felipeliras/lira-plc/README.md

# lira-plc

## Disclaimer
This project includes CAD models provided by Phoenix Contact for integration into the PCB assembly. The CAD files are used in accordance with Phoenix Contact’s usage rights for the purpose of distributing and documenting this project. Phoenix Contact remains the owner and author of the original CAD files. All product names, logos, and trademarks are the property of their respective owners.
