felipeliras/lira-plc/hardware/lira-plc.step

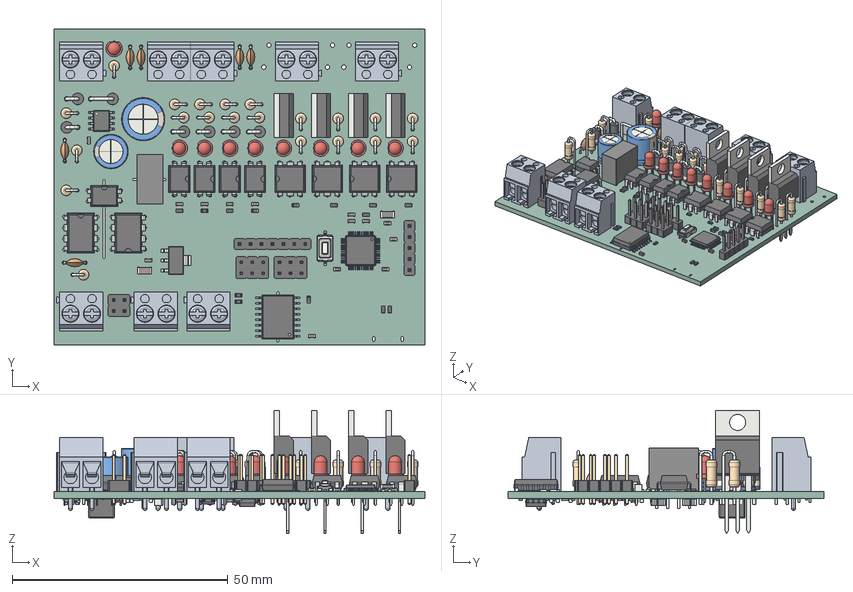
[picture p1: CAD file, 2025-01-07]
hardware/lira-plc.step
86.0 x 73.2 x 28.5 mm
D_DO-41_SOD81_P2.54mm_Vertical_AnodeUp x 6
R_Axial_DIN0207_L63mm_D25mm_P254mm_Vertical x 21
DIP-4_W7.62mm x 5
R_0603_1608Metric x 33
C_Disc_D43mm_W19mm_P500mm x 6
PinHeader_1x05_P254mm_Vertical
LED_D3.0mm x 9
CP_Radial_D80mm_P380mm
C_0603_1608Metric x 29
mps_dcdc_mee1s_sc_a
BR002 x 8
TO-220-3_Vertical x 4
PinHeader_2x03_P254mm_Vertical x 2
DIP-8_W7.62mm x 2
SOIC_16W_75x103mm_P127mm
L_1206_3216Metric x 3
DIP-6_W7.62mm x 4
CP_Radial_D100mm_P500mm
PinHeader_1x07_P254mm_Vertical
PTS636Sx25SMTRLFS
LQFP_48_7x7mm_P05mm
SOIC_8_39x49mm_P127mm x 2
SOT_223
PinHeader_2x02_P254mm_Vertical
C_1206_3216Metric
D_DO-41_SOD81_P5.08mm_Vertical_AnodeUp
SOT-23-3
L_APV_ANR6045
lira-plc_PCB
