felipeliras/lira-plc/hardware/lira-plc.kicad_pcb

## KiCad design hardware/lira-plc.kicad_pcb (2025-01-09)

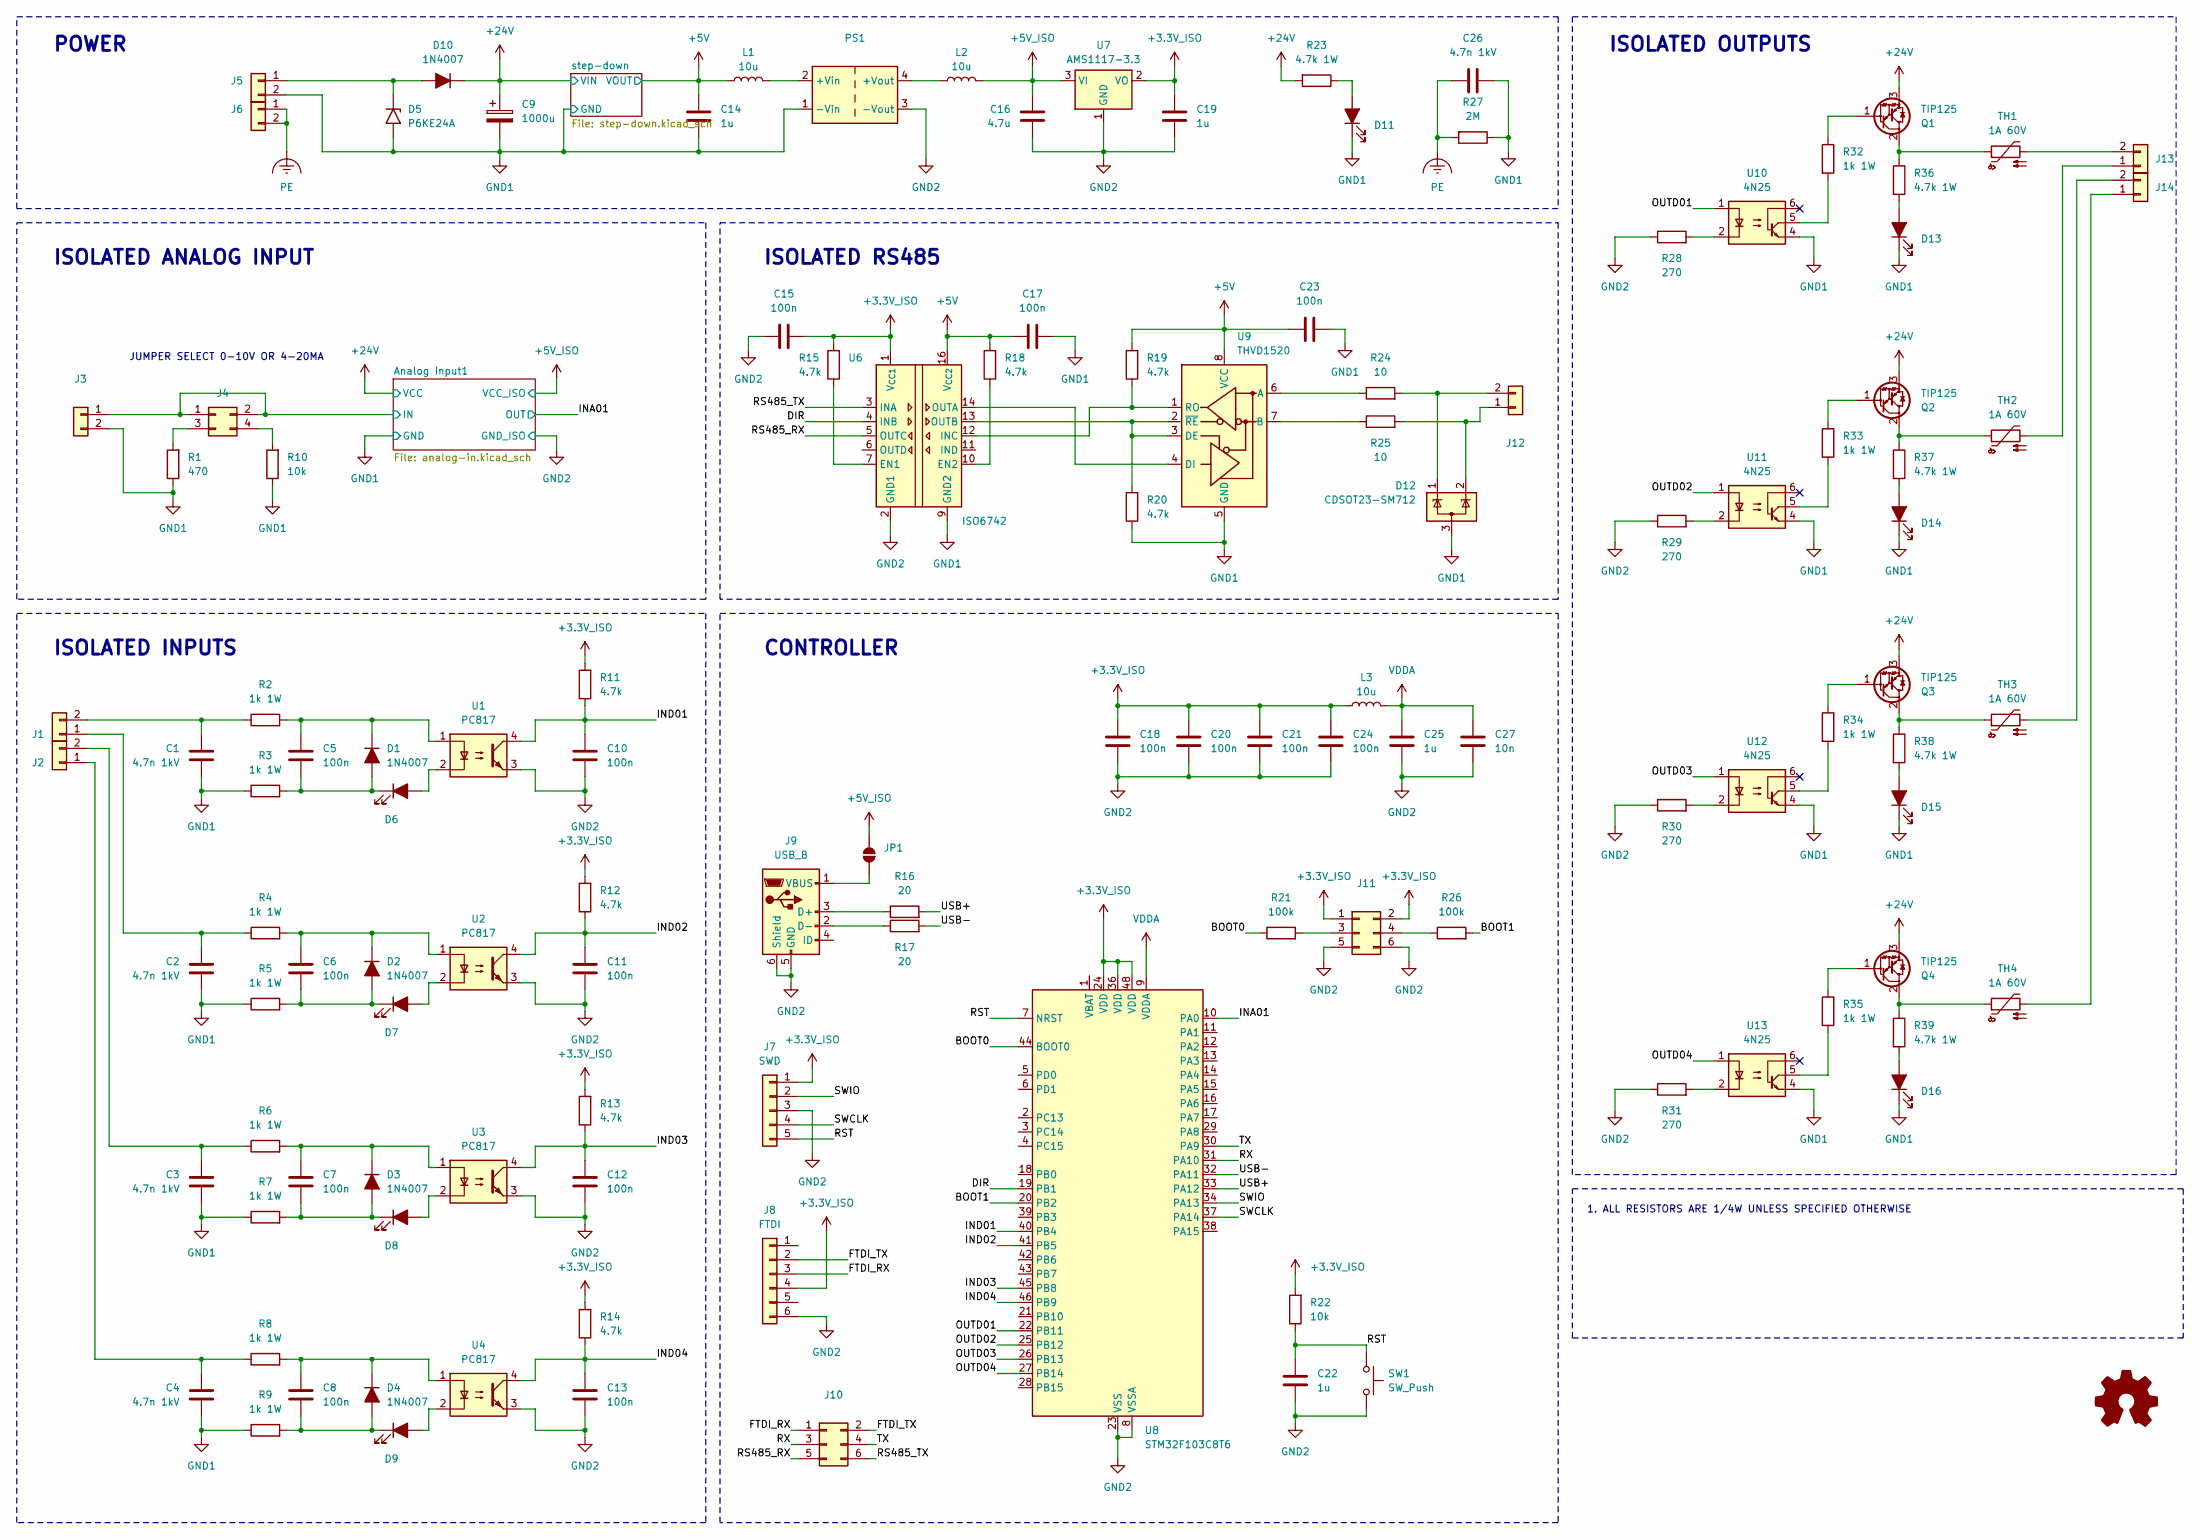
[picture p2: schematic lira-plc.kicad_sch]

Parts:
C1, C2, C3, C4, C26: 4.7n 1kV; C_Disc_D4.3mm_W1.9mm_P5.00mm
C5, C6, C7, C8, C10, C11, C12, C13, C15, C17, C18, C20, C21, C23, C24: 100n; C_0603_1608Metric_Pad1.08x0.95mm_HandSolder
C9: 1000u; CP_Radial_D10.0mm_P5.00mm
C14, C19, C22, C25: 1u; C_0603_1608Metric_Pad1.08x0.95mm_HandSolder
C16: 4.7u; C_1206_3216Metric_Pad1.33x1.80mm_HandSolder
C27: 10n; C_0603_1608Metric_Pad1.08x0.95mm_HandSolder
D1, D2, D3, D4: 1N4007; D_DO-41_SOD81_P2.54mm_Vertical_AnodeUp
D5: P6KE24A; D_DO-41_SOD81_P2.54mm_Vertical_AnodeUp
D6, D7, D8, D9, D11, D13, D14, D15, D16: LED_Filled; LED_D3.0mm
D10: 1N4007; D_DO-41_SOD81_P5.08mm_Vertical_AnodeUp
D12: CDSOT23-SM712; SOT-23-3
J1, J2, J3, J5, J6, J12, J13, J14: Conn_01x02; Metaltex-BR0
J4: Conn_02x02_Counter_Clockwise; PinHeader_2x02_P2.54mm_Vertical
J7: SWD; PinHeader_1x05_P2.54mm_Vertical
J8: FTDI; PinHeader_1x07_P2.54mm_Vertical
J9: USB_B; USB_Micro-B_Amphenol_10118193-0001LF_Horizontal
J10, J11: Conn_02x03_Odd_Even; PinHeader_2x03_P2.54mm_Vertical
JP1: SolderJumper_2_Open; SolderJumper-2_P1.3mm_Open_RoundedPad1.0x1.5mm
L1, L2, L3: 10u; L_1206_3216Metric_Pad1.42x1.75mm_HandSolder
PS1: Converter_DCDC_Murata_MEE1SxxxxSC_THT
Q1, Q2, Q3, Q4: TIP125; TO-220-3_Vertical
R1: 470; R_0603_1608Metric_Pad0.98x0.95mm_HandSolder
R2, R3, R4, R5, R6, R7, R8, R9, R32, R33, R34, R35: 1k 1W; R_Axial_DIN0207_L6.3mm_D2.5mm_P2.54mm_Vertical
R10, R22: 10k; R_0603_1608Metric_Pad0.98x0.95mm_HandSolder
R11, R12, R13, R14, R15, R18, R19, R20: 4.7k; R_0603_1608Metric_Pad0.98x0.95mm_HandSolder
R16, R17: 20; R_0603_1608Metric_Pad0.98x0.95mm_HandSolder
R21, R26: 100k; R_0603_1608Metric_Pad0.98x0.95mm_HandSolder
R23, R36, R37, R38, R39: 4.7k 1W; R_Axial_DIN0207_L6.3mm_D2.5mm_P2.54mm_Vertical
R24, R25: 10; R_0603_1608Metric_Pad0.98x0.95mm_HandSolder
R27: 2M; R_Axial_DIN0207_L6.3mm_D2.5mm_P2.54mm_Vertical
R28, R29, R30, R31: 270; R_0603_1608Metric_Pad0.98x0.95mm_HandSolder
SW1: SW_Push; SW_Tactile_SPST_NO_Straight_CK_PTS636Sx25SMTRLFS
TH1, TH2, TH3, TH4: 1A 60V; Fuse_Bourns_MF-RHT500
U1, U2, U3, U4: PC817; DIP-4_W7.62mm
U6: ISO6742; SOIC-16W_7.5x10.3mm_P1.27mm
U7: AMS1117-3.3; SOT-223-3_TabPin2
U8: STM32F103C8T6; LQFP-48_7x7mm_P0.5mm
U9: THVD1520; SOIC-8_3.9x4.9mm_P1.27mm
U10, U11, U12, U13: 4N25; DIP-6_W7.62mm

Connections:
+3.3V_ISO: C15.1, C18.1, C19.1, C20.1, C21.1, C24.1, J7.1, J8.4, J11.1, J11.2, L3.1, R11.2, R12.2, R13.2, R14.2, R15.2, R22.2, U6.1 (V_{CC1}), U7.2 (VO), U8.24 (VDD), U8.36 (VDD), U8.48 (VDD)
+5V: C14.1, C17.2, C23.1, L1.1, R18.2, R19.2, U6.16 (V_{CC2}), U9.8 (VCC); also elsewhere on the board
+5V_ISO: C16.1, JP1.2 (B), L2.2, U7.3 (VI); also elsewhere on the board
+24V: C9.1, D10.1 (K), Q1.3 (E), Q2.3 (E), Q3.3 (E), Q4.3 (E), R23.2; also elsewhere on the board
/Analog Input1/IN: J3.1, J4.1, J4.2; also elsewhere on the board
/BOOT0: R21.1, U8.44 (BOOT0)
/BOOT1: R26.2, U8.20 (PB2)
/DIR: U6.4 (INB), U8.19 (PB1)
/FTDI_RX: J8.3, J10.1
/FTDI_TX: J8.2, J10.2
/INA01: U8.10 (PA0); also elsewhere on the board
/IND01: C10.1, R11.1, U1.4, U8.40 (PB4)
/IND02: C11.1, R12.1, U2.4, U8.41 (PB5)
/IND03: C12.1, R13.1, U3.4, U8.45 (PB8)
/IND04: C13.1, R14.1, U4.4, U8.46 (PB9)
/OUTD01: U8.22 (PB11), U10.1
/OUTD02: U8.25 (PB12), U11.1
/OUTD03: U8.26 (PB13), U12.1
/OUTD04: U8.27 (PB14), U13.1
/RS485_RX: J10.5, U6.5 (OUTC)
/RS485_TX: J10.6, U6.3 (INA)
/RST: C22.1, J7.5, R22.1, SW1.1, U8.7 (NRST)
/RX: J10.3, U8.31 (PA10)
/SWCLK: J7.4, U8.37 (PA14)
/SWIO: J7.2, U8.34 (PA13)
/TX: J10.4, U8.30 (PA9)
/USB+: R16.2, U8.33 (PA12)
/USB-: R17.2, U8.32 (PA11)
GND1: C1.2, C2.2, C3.2, C4.2, C9.2, C14.2, C17.1, C23.2, C26.2, D5.2 (A2), D11.1 (K), D12.3 (A), D13.1 (K), D14.1 (K), D15.1 (K), D16.1 (K), J3.2, J5.2, PS1.1 (-Vin), R1.1, R3.1, R5.1, R7.1, R9.1, R10.1, R20.1, R27.1, U6.9 (GND2), U6.15 (GND2), U9.5 (GND), U10.4, U11.4, U12.4, U13.4; also elsewhere on the board
GND2: C10.2, C11.2, C12.2, C13.2, C15.2, C16.2, C18.2, C19.2, C20.2, C21.2, C22.2, C24.2, C25.2, C27.2, J7.3, J8.6, J9.5 (GND), J9.6 (Shield), J11.5, J11.6, PS1.3 (-Vout), R28.1, R29.1, R30.1, R31.1, SW1.2, U1.3, U2.3, U3.3, U4.3, U6.2 (GND1), U6.8 (GND1), U7.1 (GND), U8.8 (VSSA), U8.23 (VSS), U8.35 (VSS), U8.47 (VSS); also elsewhere on the board
unnamed: C5.2, D1.2 (A), D6.1 (K), R3.2
unnamed: C5.1, D1.1 (K), R2.2, U1.1
unnamed: C6.2, D2.2 (A), D7.1 (K), R5.2
unnamed: C6.1, D2.1 (K), R4.2, U2.1
unnamed: C7.2, D3.2 (A), D8.1 (K), R7.2
unnamed: C7.1, D3.1 (K), R6.2, U3.1
unnamed: C8.2, D4.2 (A), D9.1 (K), R9.2
unnamed: C8.1, D4.1 (K), R8.2, U4.1
unnamed: D6.2 (A), U1.2
unnamed: D7.2 (A), U2.2
unnamed: D8.2 (A), U3.2
unnamed: D9.2 (A), U4.2
unnamed: D5.1 (A1), D10.2 (A), J5.1
unnamed: D11.2 (A), R23.1
unnamed: D13.2 (A), R36.2
unnamed: D14.2 (A), R37.2
unnamed: D15.2 (A), R38.2
unnamed: D16.2 (A), R39.2
unnamed: C2.1, J1.1, R4.1
unnamed: C1.1, J1.2, R2.1
unnamed: C4.1, J2.1, R8.1
unnamed: C3.1, J2.2, R6.1
unnamed: J4.3, R1.2
unnamed: J4.4, R10.2
unnamed: J9.3 (D+), R16.1
unnamed: J9.2 (D-), R17.1
unnamed: J9.1 (VBUS), JP1.1 (A)
unnamed: J11.3, R21.2
unnamed: J11.4, R26.1
unnamed: D12.2 (K), J12.1, R25.2
unnamed: D12.1 (K), J12.2, R24.2
unnamed: J13.1, TH2.2
unnamed: J13.2, TH1.2
unnamed: J14.1, TH4.2
unnamed: J14.2, TH3.2
unnamed: L1.2, PS1.2 (+Vin)
unnamed: L2.1, PS1.4 (+Vout)
unnamed: Q1.1 (B), R32.1
unnamed: Q1.2 (C), R36.1, TH1.1
unnamed: Q2.1 (B), R33.1
unnamed: Q2.2 (C), R37.1, TH2.1
unnamed: Q3.1 (B), R34.1
unnamed: Q3.2 (C), R38.1, TH3.1
unnamed: Q4.1 (B), R35.1
unnamed: Q4.2 (C), R39.1, TH4.1
unnamed: R28.2, U10.2
unnamed: R29.2, U11.2
unnamed: R30.2, U12.2
unnamed: R31.2, U13.2
unnamed: R32.2, U10.5
unnamed: R33.2, U11.5
unnamed: R34.2, U12.5
unnamed: R35.2, U13.5
unnamed: R15.1, U6.7 (EN1)
unnamed: R18.1, U6.10 (EN2)
unnamed: R19.1, U6.12 (INC), U9.1 (RO)
unnamed: U6.14 (OUTA), U9.4 (DI)
unnamed: R20.2, U6.13 (OUTB), U9.2 (~RE), U9.3 (DE)
unnamed: R24.1, U9.6 (A)
unnamed: R25.1, U9.7 (B)
PE: C26.1, J6.1, J6.2, R27.2
VDDA: C25.1, C27.1, L3.2, U8.9 (VDDA)

Notes on the sheet:
POWER
JUMPER SELECT 0-10V OR 4-20MA
ISOLATED ANALOG INPUT
ISOLATED OUTPUTS
ISOLATED INPUTS
CONTROLLER
1. ALL RESISTORS ARE 1/4W UNLESS SPECIFIED OTHERWISE
ISOLATED RS485

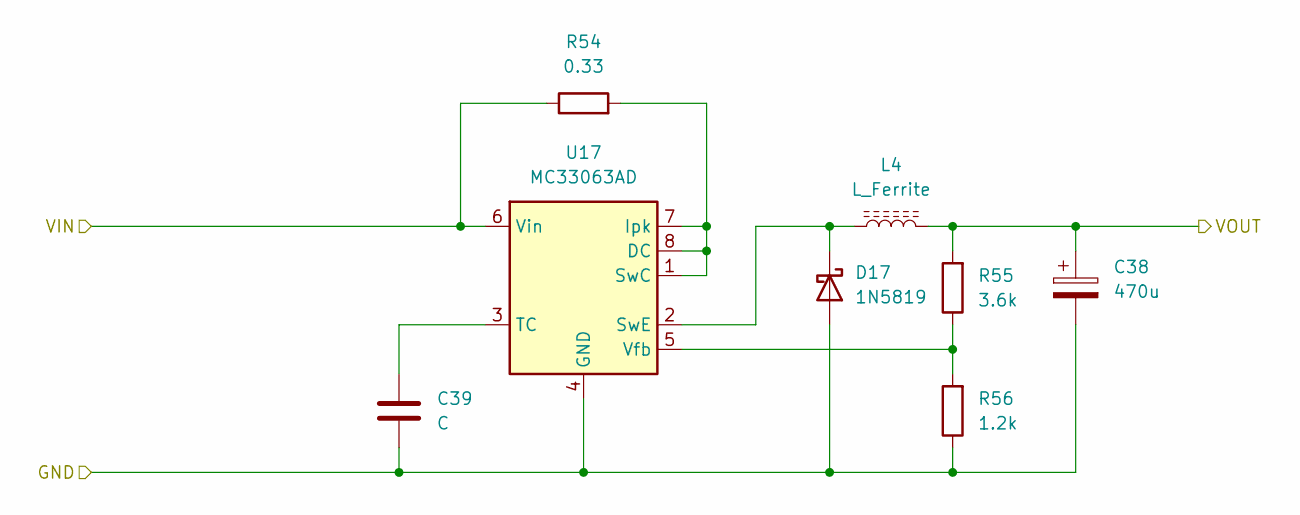
[picture p3: schematic step-down.kicad_sch]

Parts:
C38: 470u; CP_Radial_D8.0mm_P3.80mm
C39: C; C_0603_1608Metric_Pad1.08x0.95mm_HandSolder
D17: 1N5819; D_DO-41_SOD81_P2.54mm_Vertical_AnodeUp
L4: L_Ferrite; L_APV_ANR6045
R54: 0.33; R_Axial_DIN0207_L6.3mm_D2.5mm_P2.54mm_Vertical
R55: 3.6k; R_0603_1608Metric_Pad0.98x0.95mm_HandSolder
R56: 1.2k; R_0603_1608Metric_Pad0.98x0.95mm_HandSolder
U17: MC33063AD; SOIC-8_3.9x4.9mm_P1.27mm

Connections:
+5V: C38.1, L4.2, R55.2; also elsewhere on the board
+24V: R54.1, U17.6 (Vin); also elsewhere on the board
GND1: C38.2, C39.2, D17.2 (A), R56.1, U17.4 (GND); also elsewhere on the board
unnamed: D17.1 (K), L4.1, U17.2 (SwE)
unnamed: R54.2, U17.1 (SwC), U17.7 (Ipk), U17.8 (DC)
unnamed: C39.1, U17.3 (TC)
unnamed: R55.1, R56.2, U17.5 (Vfb)

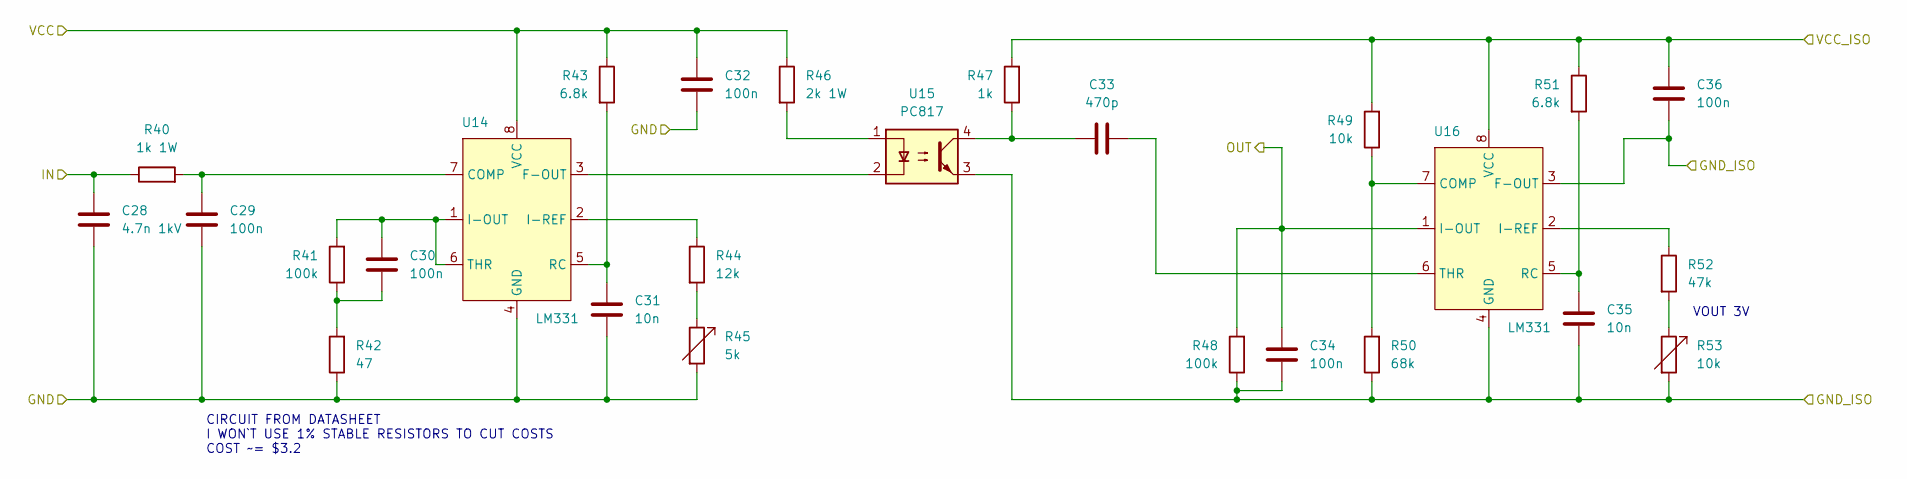
[picture p4: schematic analog-in.kicad_sch]

Parts:
C28: 4.7n 1kV; C_Disc_D4.3mm_W1.9mm_P5.00mm
C29, C30, C32, C34, C36: 100n; C_0603_1608Metric_Pad1.08x0.95mm_HandSolder
C31, C35: 10n; C_0603_1608Metric_Pad1.08x0.95mm_HandSolder
C33: 470p; C_0603_1608Metric_Pad1.08x0.95mm_HandSolder
R40: 1k 1W; R_Axial_DIN0207_L6.3mm_D2.5mm_P2.54mm_Vertical
R41, R48: 100k; R_0603_1608Metric_Pad0.98x0.95mm_HandSolder
R42: 47; R_0603_1608Metric_Pad0.98x0.95mm_HandSolder
R43, R51: 6.8k; R_0603_1608Metric_Pad0.98x0.95mm_HandSolder
R44: 12k; R_0603_1608Metric_Pad0.98x0.95mm_HandSolder
R45: 5k; Potentiometer_Bourns_TC33X_Vertical
R46: 2k 1W; R_Axial_DIN0207_L6.3mm_D2.5mm_P2.54mm_Vertical
R47: 1k; R_0603_1608Metric_Pad0.98x0.95mm_HandSolder
R49: 10k; R_0603_1608Metric_Pad0.98x0.95mm_HandSolder
R50: 68k; R_0603_1608Metric_Pad0.98x0.95mm_HandSolder
R52: 47k; R_0603_1608Metric_Pad0.98x0.95mm_HandSolder
R53: 10k; Potentiometer_Bourns_TC33X_Vertical
U14, U16: LM331; DIP-8_W7.62mm
U15: PC817; DIP-4_W7.62mm

Connections:
+5V_ISO: C36.2, R47.2, R49.2, R51.1, U16.8 (VCC); also elsewhere on the board
+24V: C32.2, R43.1, R46.1, U14.8 (VCC); also elsewhere on the board
/Analog Input1/IN: C28.1, R40.1; also elsewhere on the board
/INA01: C34.1, R48.2, U16.1 (I-OUT); also elsewhere on the board
GND1: C28.2, C29.2, C31.1, C32.1, R42.1, R45.2, U14.4 (GND); also elsewhere on the board
GND2: C34.2, C35.1, C36.1, R48.1, R50.1, R53.2, U15.3, U16.3 (F-OUT), U16.4 (GND); also elsewhere on the board
unnamed: C30.2, R41.1, R42.2
unnamed: C33.1, R47.1, U15.4
unnamed: R44.2, R45.1
unnamed: R46.2, U15.1
unnamed: R52.2, R53.1
unnamed: C29.1, R40.2, U14.7 (COMP)
unnamed: U14.3 (F-OUT), U15.2
unnamed: C30.1, R41.2, U14.1 (I-OUT), U14.6 (THR)
unnamed: R44.1, U14.2 (I-REF)
unnamed: C31.2, R43.2, U14.5 (RC)
unnamed: R49.1, R50.2, U16.7 (COMP)
unnamed: R52.1, U16.2 (I-REF)
unnamed: C35.2, R51.2, U16.5 (RC)
unnamed: C33.2, U16.6 (THR)

Notes on the sheet:
VOUT 3V
CIRCUIT FROM DATASHEET I WON`T USE 1% STABLE RESISTORS TO CUT COSTS COST ~= $3.2

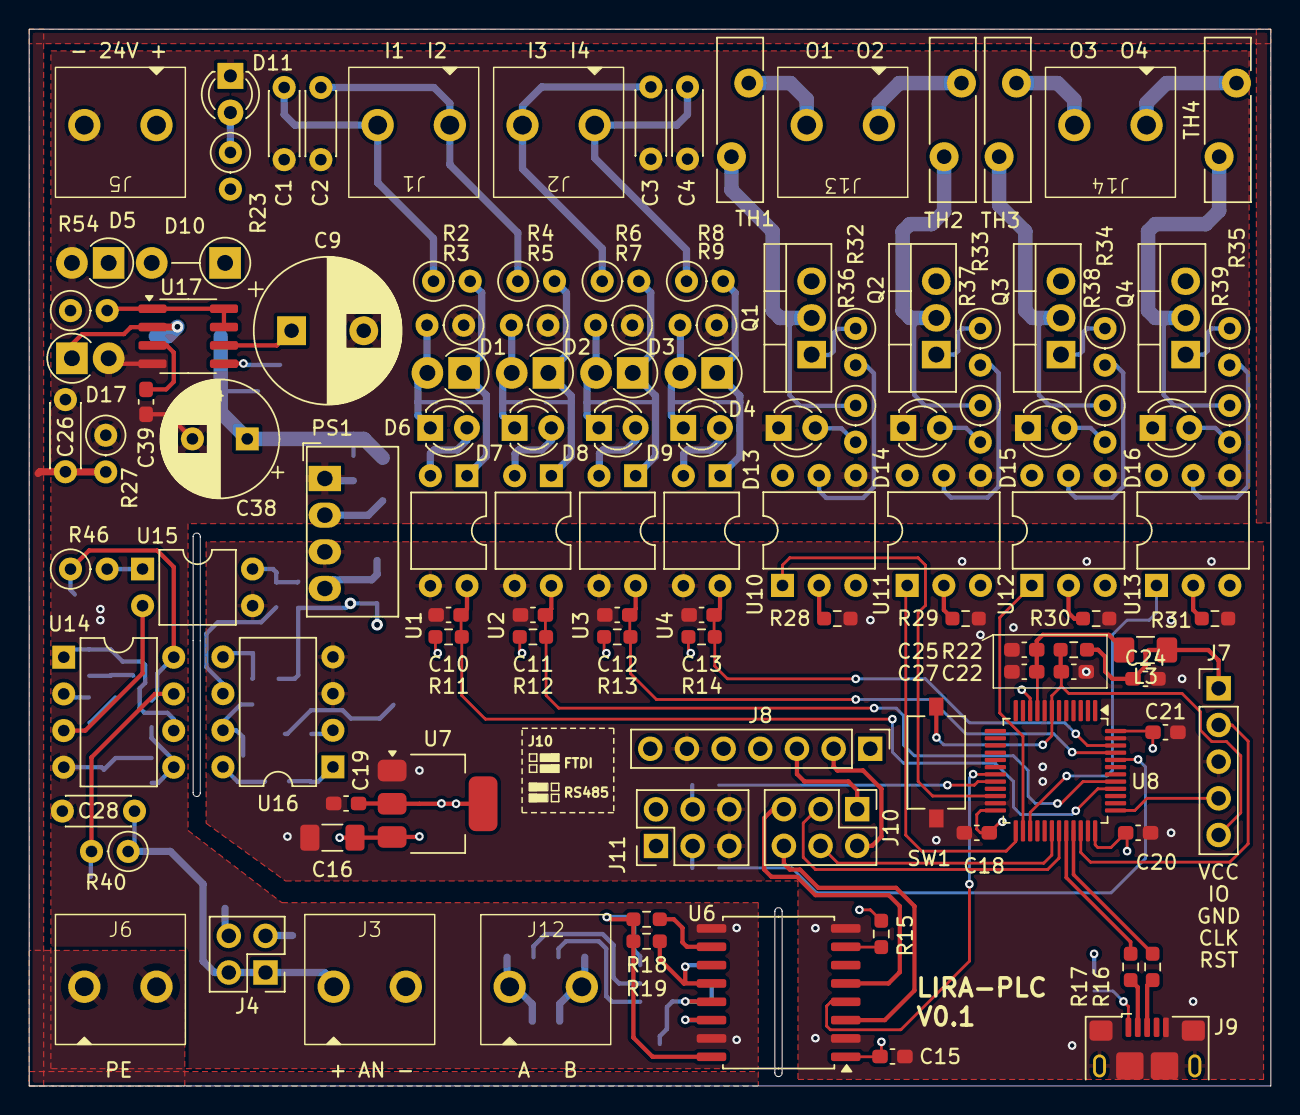
[picture p5: board lira-plc.kicad_pcb from above]

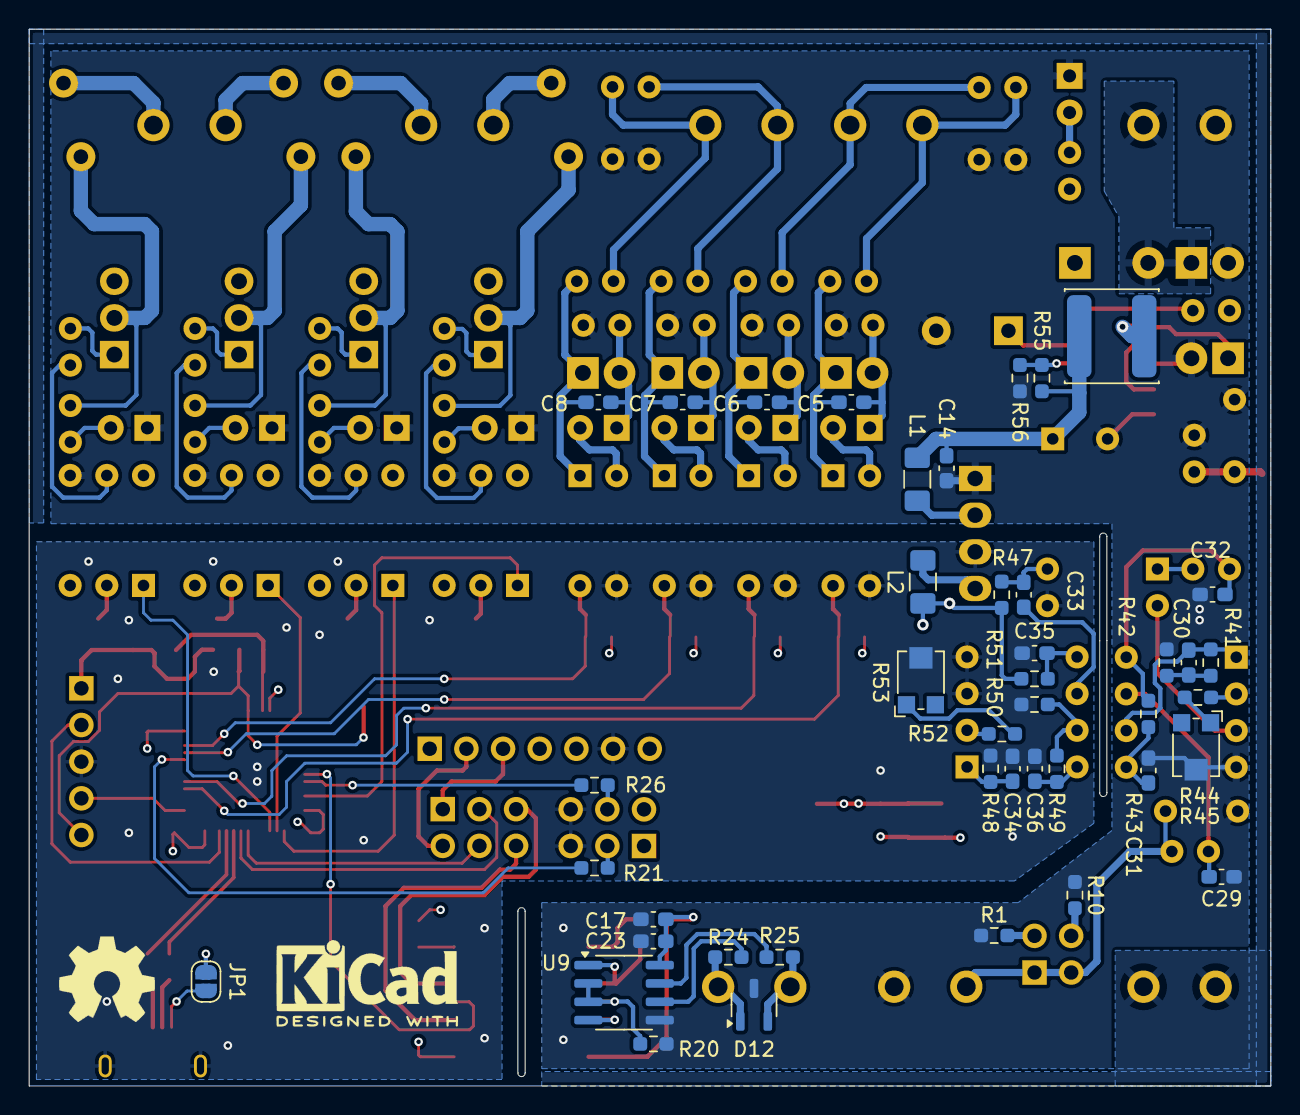
[picture p6: board lira-plc.kicad_pcb from below]

Board: 4 copper layers, 86.0 x 73.2 mm, 156 parts (42 on the bottom side), 110 nets.
