felipeliras/lira-plc/(commit log)

2024-12-10 Input Draft
    [lira-plc.kicad_pcb, lira-plc.kicad_sch]
2024-12-12 component values
    [lira-plc.kicad_sch]
2024-12-13 power supply and output
    [lira-plc.kicad_sch]
2024-12-13 organizing the circuit
    [lira-plc.kicad_sch]
2024-12-14 analog input finished
    [analog-in.kicad_sch, lira-plc.kicad_sch]
2024-12-14 power supply simplified to just 24VDC
    [analog-in.kicad_sch, lira-plc.kicad_sch]
2024-12-14 analog input and power supply
    [analog-in.kicad_sch, lira-plc.kicad_sch]
2024-12-15 support circuit for microcontroller
    [analog-in.kicad_sch, lira-plc.kicad_sch]
2024-12-15 saving the rs485 transceiver
    [lira-plc.kicad_sch]
2024-12-17 modbus rs485 added
    [lira-plc.kicad_sch]
2024-12-17 annotate schematic
    [analog-in.kicad_sch, lira-plc.kicad_sch]
2024-12-17 capacitor in power supply
    [lira-plc.kicad_sch]
2024-12-28 end of schematic drawing
    isolated modbus and controller circuit added
    [analog-in.kicad_sch, lira-plc.kicad_sch]
2025-01-03 footprint selection for all components
    [analog-in.kicad_sch, lira-plc.kicad_pcb, lira-plc.kicad_sch]
2025-01-04 input routed
    [lira-plc.kicad_pcb, lira-plc.kicad_sch]
2025-01-05 smaller size io
    [analog-in.kicad_sch, lira-plc.kicad_pcb, lira-plc.kicad_sch]
2025-01-05 power components placement
    [lira-plc.kicad_pcb, lira-plc.kicad_sch, step-down.kicad_sch]
2025-01-05 75% routed and minor fixes
    Some wrong ground connections fixed, all external circuit routed, references organized
    [analog-in.kicad_sch, lira-plc.kicad_pcb, lira-plc.kicad_sch, step-down.kicad_sch]
2025-01-07 pcb routed, some minor fixes, needs revision before gerbers
    [lira-plc.kicad_pcb, lira-plc.kicad_sch, lira-plc.step, step-down.kicad_sch]
2025-01-09 gerber files
    [lira-plc-B_Cu.gbr, lira-plc-B_Mask.gbr, lira-plc-B_Paste.gbr, lira-plc-B_Silkscreen.gbr, lira-plc-Edge_Cuts.gbr, lira-plc-F_Cu.gbr, lira-plc-F_Mask.gbr, lira-plc-F_Paste.gbr]
2025-10-17 changed: improved schematics following Andrew Greenberg's best practices at Kicon 2025
    Useful Schematics Or, “Don’t make me want to murder you” Andrew Greenberg Senior Instructor, Portland State University adg4@pdx.edu
    KiCon North America 2025 Day 2: https://www.youtube.com/watch?v=h8s6T9pnWlY&t=23595s
    [01-power.kicad_sch, 02-step-down.kicad_sch, 03-inputs.kicad_sch, 04-analog-in.kicad_sch, 05-ucontroller.kicad_sch, 06-outputs.kicad_sch]
